Shisong-LI/Tsinghua-KB-Magnet-Open-Source/metadata/file-manifest.csv

path | source_path | size_bytes | sha256 | format | role
hardware/drawings/A5_Cover - 图纸.pdf | 图纸/A5_Cover - 图纸.pdf | 136703 | d9381b79babea124f1c9e8039828075bba117d09c8c25e4abf5d342fc5d3db3c | PDF | drawing-pdf
hardware/drawings/A5_Cover.SLDDRW | 图纸/A5_Cover.SLDDRW | 441877 | 97224264419adcaf0b62cd723ca5f9ee02789884d5e3d114f76e61529ae92d68 | SLDDRW | drawing
hardware/drawings/A5_Cover.SLDPRT | 图纸/A5_Cover.SLDPRT | 211247 | c3634bf68eb07473ba412b9cf486f4e0c87c6d2c47d599e6dcd05f07a0fd2de1 | SLDPRT | part
hardware/drawings/A5_Cover.STEP | 图纸/A5_Cover.STEP | 250598 | 1846d06651c39f89eef82ffe650faa5e057a3091f0c7ed0b60df97f60c061aa5 | STEP | exchange
hardware/drawings/A5_InnerL - 图纸.pdf | 图纸/A5_InnerL - 图纸.pdf | 63132 | 8e23bdd94e105e076f227bb8b3a257c28a4f538de69c8bba346e6d6d42adcec2 | PDF | drawing-pdf
hardware/drawings/A5_InnerL.SLDDRW | 图纸/A5_InnerL.SLDDRW | 182580 | 98d02a173ba5a83216cbe8c66720d75f1d4490e6fad9af991800a24dea2006e9 | SLDDRW | drawing
hardware/drawings/A5_InnerL.SLDPRT | 图纸/A5_InnerL.SLDPRT | 103981 | 073f107fbadd0505143599769134beae438c3ad43815fd00e06f6801c19ed73d | SLDPRT | part
hardware/drawings/A5_InnerL.STEP | 图纸/A5_InnerL.STEP | 31354 | a3d109f52731be0d8d959fe59bb94d309607ea42ef0b9fddd9e796b562a10067 | STEP | exchange
hardware/drawings/A5_InnerS - 图纸.pdf | 图纸/A5_InnerS - 图纸.pdf | 63033 | e7a253ab4c9a4071441f85f885e89a9850795416e2297c697473997f7caa80d7 | PDF | drawing-pdf
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
hardware/solidworks/内磁轭卡件V1.0.SLDPRT | 内磁轭卡件V1.0.SLDPRT | 250544 | edf80ae4a9b94ca8734a57c9467cfc0332b01028d7f0974bba070ce14b471a93 | SLDPRT | part
