Shisong-LI/Tsinghua-KB-Magnet-Open-Source/hardware/solidworks/01.THUKB-CY-01-00 M磁组.SLDASM

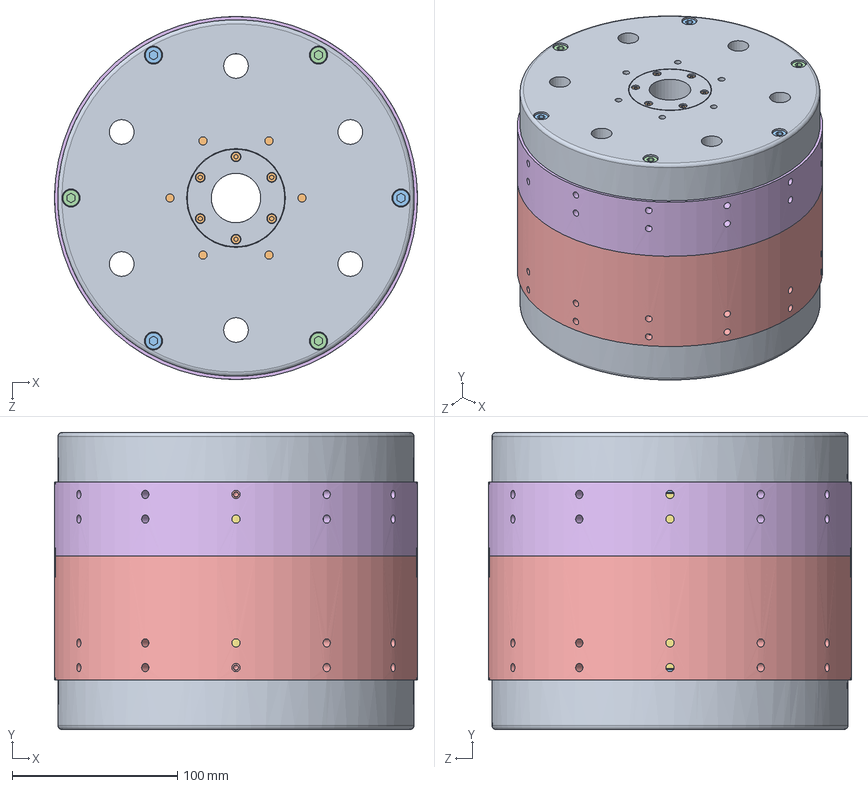
[picture p1: CAD file, 2026-11-11]
hardware/solidworks/01.THUKB-CY-01-00 M磁组.SLDASM
220.0 x 180.0 x 220.0 mm
A5_CoverV1.0 x 2
A5_SmCoV1.0 x 2
A5_InnerLV1.0
A5_InnerSV1.0
A5_OuterLV1.0
A5_OuterSV1.0
内磁轭卡件V1.0 x 2
下部磁体固定件V1.0
上部磁体固定件V1.0
内六角圆柱头螺钉M3×8 x 12
内六角圆柱头螺钉M6×30 x 9
内六角圆柱头螺钉M6×80 x 3
GB／T77-2000内六角平端紧定螺钉M6×10 x 6
