Shisong-LI/Tsinghua-KB-Magnet-Open-Source/hardware/drawings/下部磁体固定件.STEP

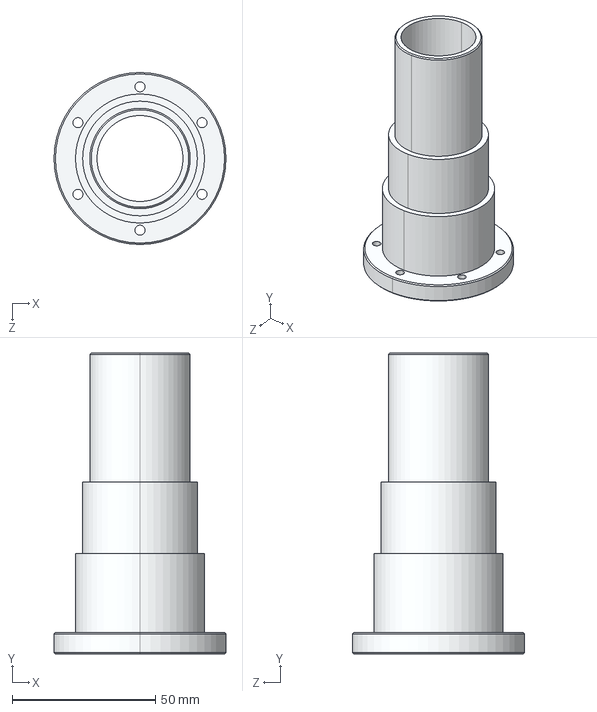
[picture p2: CAD file, 2026-11-11]
hardware/drawings/下部磁体固定件.STEP
60.0 x 105.0 x 60.0 mm
