Shisong-LI/Tsinghua-KB-Magnet-Open-Source/hardware/solidworks/上部磁体固定件V1.0.SLDPRT

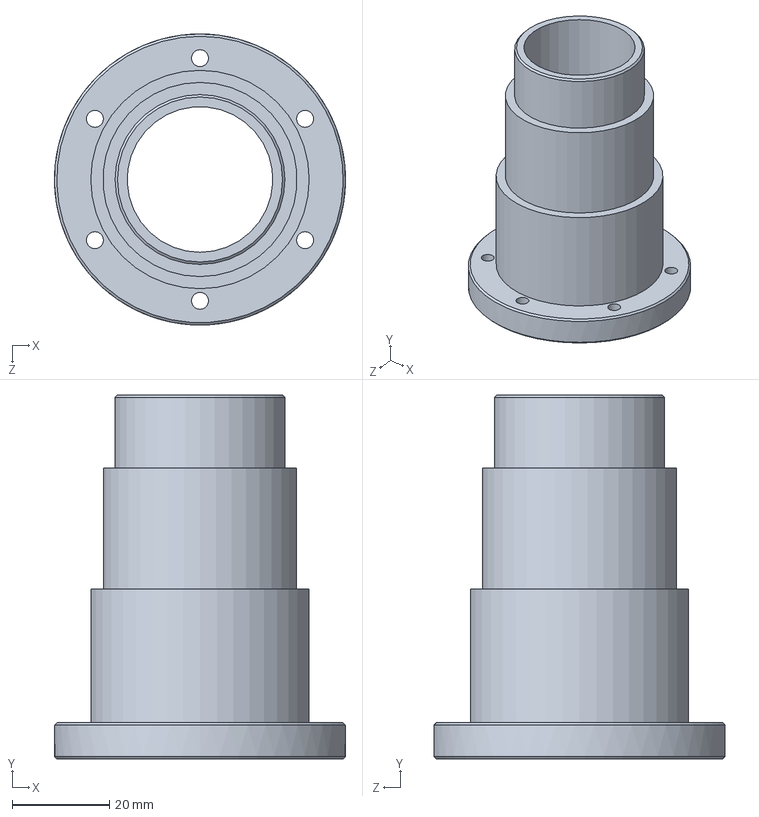
[picture p3: CAD file, 2026-11-11]
hardware/solidworks/上部磁体固定件V1.0.SLDPRT
60.0 x 75.0 x 60.0 mm
