Shisong-LI/Tsinghua-KB-Magnet-Open-Source/hardware/drawings/A5_InnerS.STEP

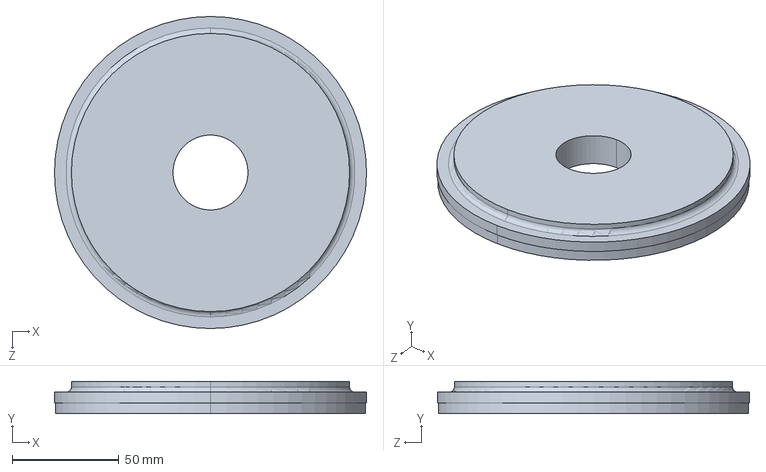
[picture p4: CAD file, 2026-11-11]
hardware/drawings/A5_InnerS.STEP
145.8 x 15.0 x 145.8 mm
