Shisong-LI/Tsinghua-KB-Magnet-Open-Source/hardware/solidworks/内六角圆柱头螺钉M6×30.SLDPRT

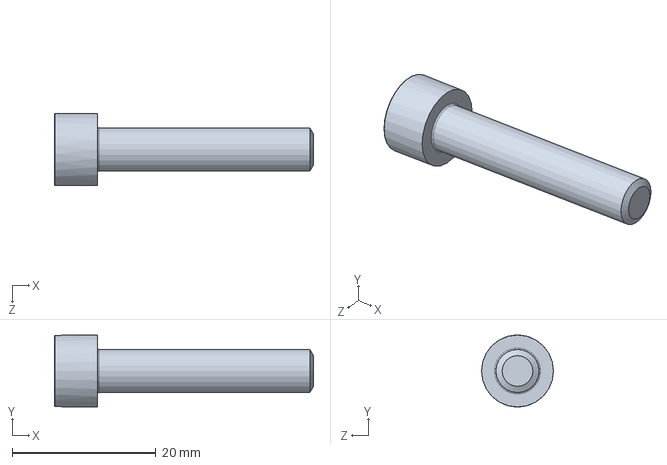
[picture p5: CAD file, 2026-11-11]
hardware/solidworks/内六角圆柱头螺钉M6×30.SLDPRT
36.0 x 10.0 x 10.0 mm
