Shisong-LI/Tsinghua-KB-Magnet-Open-Source/hardware/drawings/内磁轭卡件.STEP

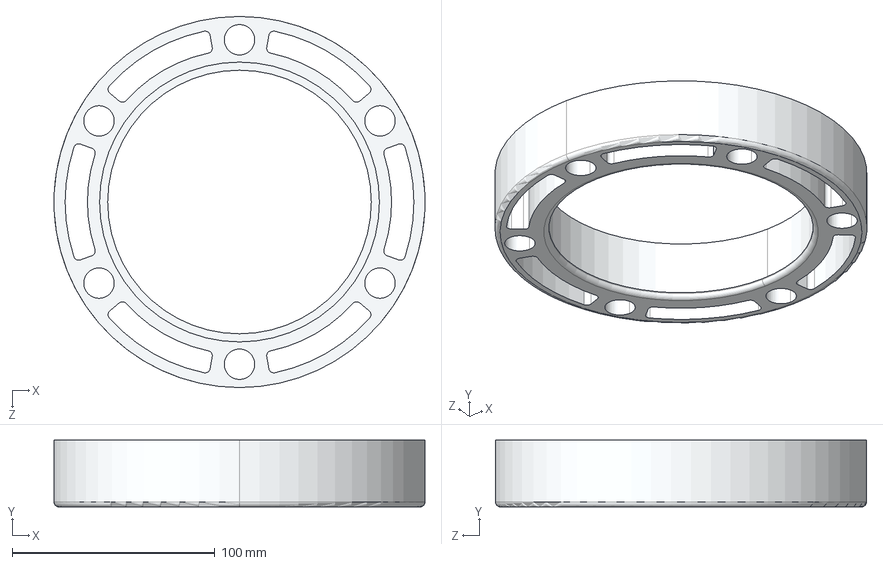
[picture p6: CAD file, 2026-11-11]
hardware/drawings/内磁轭卡件.STEP
183.0 x 33.0 x 183.0 mm
