Shisong-LI/Tsinghua-KB-Magnet-Open-Source/hardware/solidworks/内六角圆柱头螺钉M6×80.SLDPRT

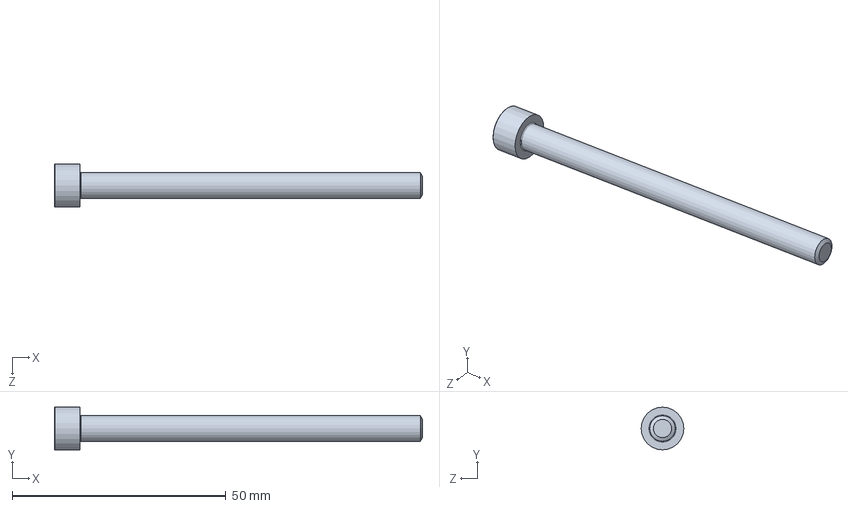
[picture p7: CAD file, 2026-11-11]
hardware/solidworks/内六角圆柱头螺钉M6×80.SLDPRT
86.0 x 10.0 x 10.0 mm
