Shisong-LI/Tsinghua-KB-Magnet-Open-Source/hardware/solidworks/A5_InnerSV1.0.SLDPRT

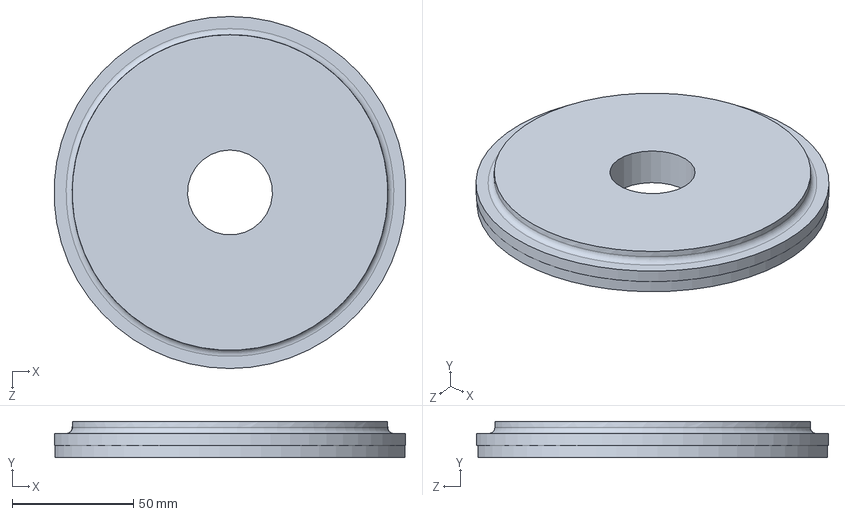
[picture p8: CAD file, 2026-11-11]
hardware/solidworks/A5_InnerSV1.0.SLDPRT
144.8 x 15.0 x 145.0 mm
