Shisong-LI/Tsinghua-KB-Magnet-Open-Source/hardware/drawings/A5_SmCo.SLDPRT

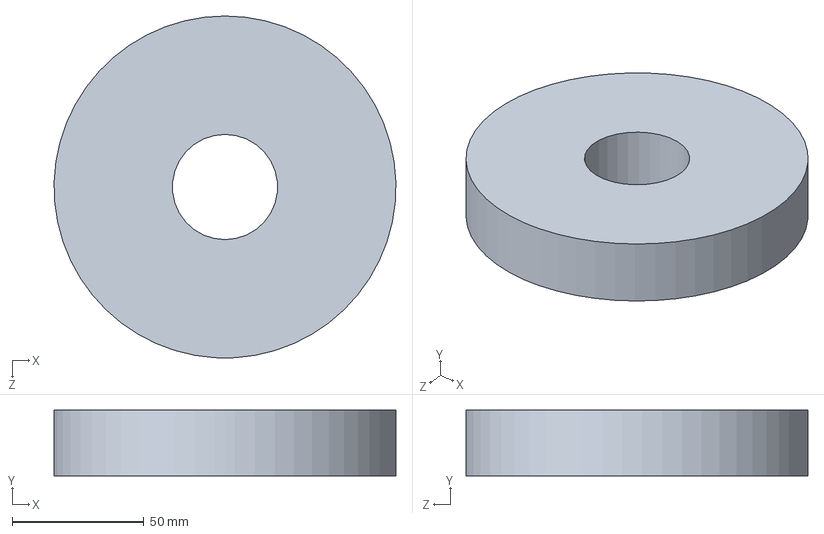
[picture p9: CAD file, 2026-11-11]
hardware/drawings/A5_SmCo.SLDPRT
129.9 x 25.0 x 130.0 mm
