Shisong-LI/Tsinghua-KB-Magnet-Open-Source/hardware/solidworks/A5_OuterSV1.0.SLDPRT

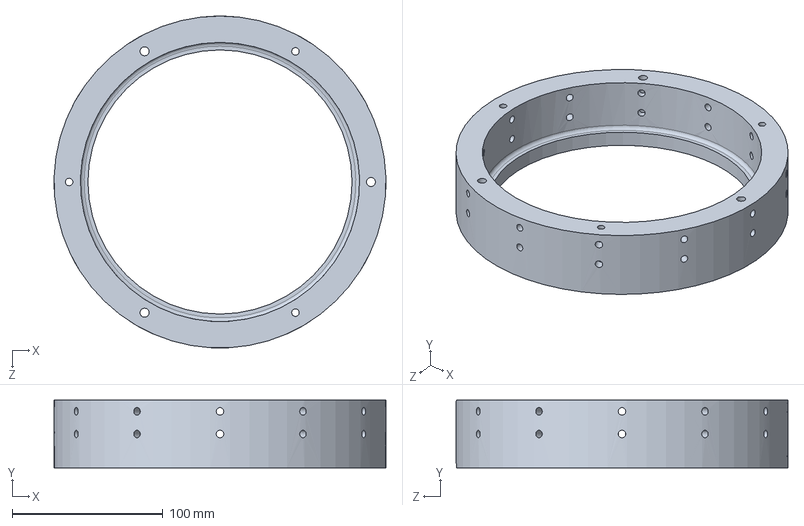
[picture p10: CAD file, 2026-11-11]
hardware/solidworks/A5_OuterSV1.0.SLDPRT
220.0 x 45.0 x 220.0 mm
