Shisong-LI/Tsinghua-KB-Magnet-Open-Source/hardware/drawings/A5_InnerL.STEP

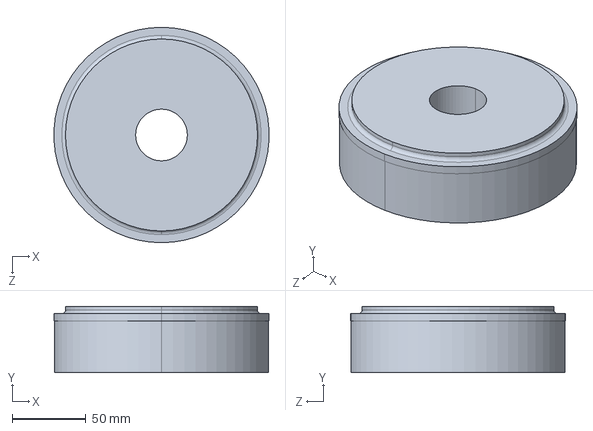
[picture p11: CAD file, 2026-11-11]
hardware/drawings/A5_InnerL.STEP
145.6 x 45.0 x 145.8 mm
