Shisong-LI/Tsinghua-KB-Magnet-Open-Source/hardware/drawings/A5_OuterS.STEP

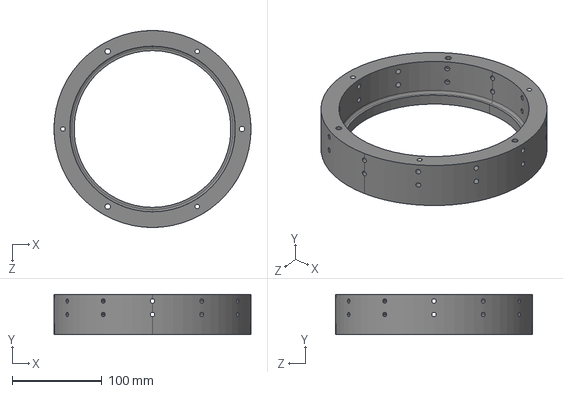
[picture p12: CAD file, 2026-11-11]
hardware/drawings/A5_OuterS.STEP
220.0 x 45.0 x 220.0 mm
