Shisong-LI/Tsinghua-KB-Magnet-Open-Source/hardware/drawings/A5_OuterLV1.0.STEP

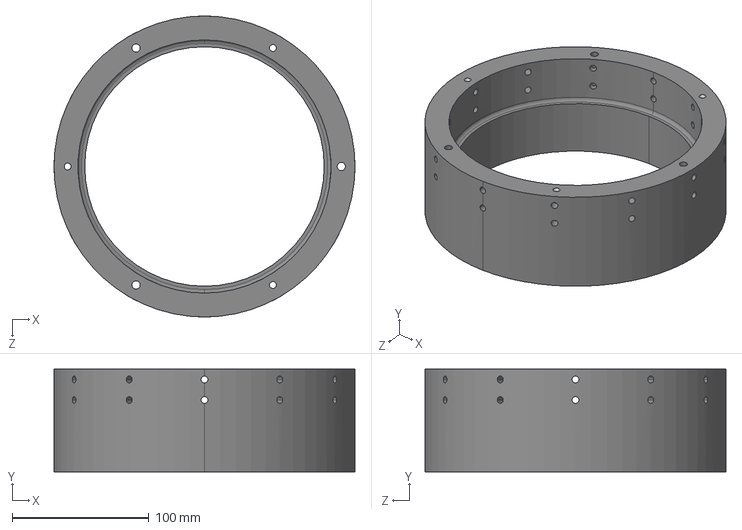
[picture p13: CAD file, 2026-11-11]
hardware/drawings/A5_OuterLV1.0.STEP
220.0 x 75.0 x 220.0 mm
