Shisong-LI/Tsinghua-KB-Magnet-Open-Source/hardware/solidworks/内磁轭卡件V1.0.SLDPRT

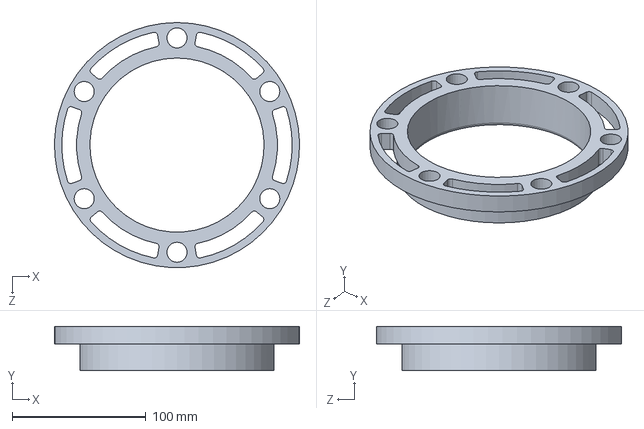
[picture p14: CAD file, 2026-11-11]
hardware/solidworks/内磁轭卡件V1.0.SLDPRT
182.9 x 33.0 x 182.8 mm
