Shisong-LI/Tsinghua-KB-Magnet-Open-Source/hardware/drawings/A5_Cover.STEP

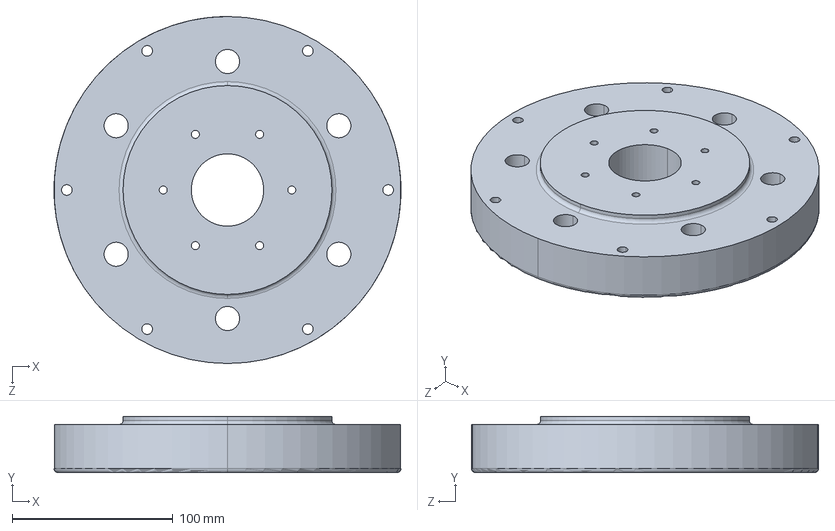
[picture p15: CAD file, 2026-11-11]
hardware/drawings/A5_Cover.STEP
216.0 x 35.0 x 216.0 mm
