Shisong-LI/Tsinghua-KB-Magnet-Open-Source/hardware/solidworks/A5_InnerLV1.0.SLDPRT

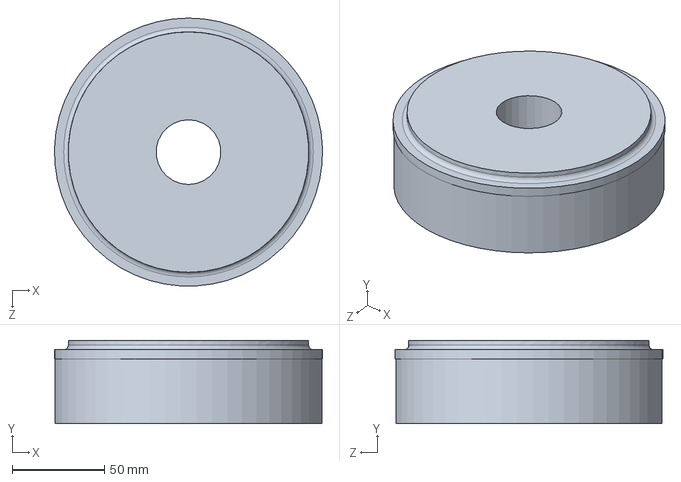
[picture p16: CAD file, 2026-11-11]
hardware/solidworks/A5_InnerLV1.0.SLDPRT
144.9 x 45.0 x 144.9 mm
