Shisong-LI/Tsinghua-KB-Magnet-Open-Source/hardware/solidworks/内六角圆柱头螺钉M3×8.SLDPRT

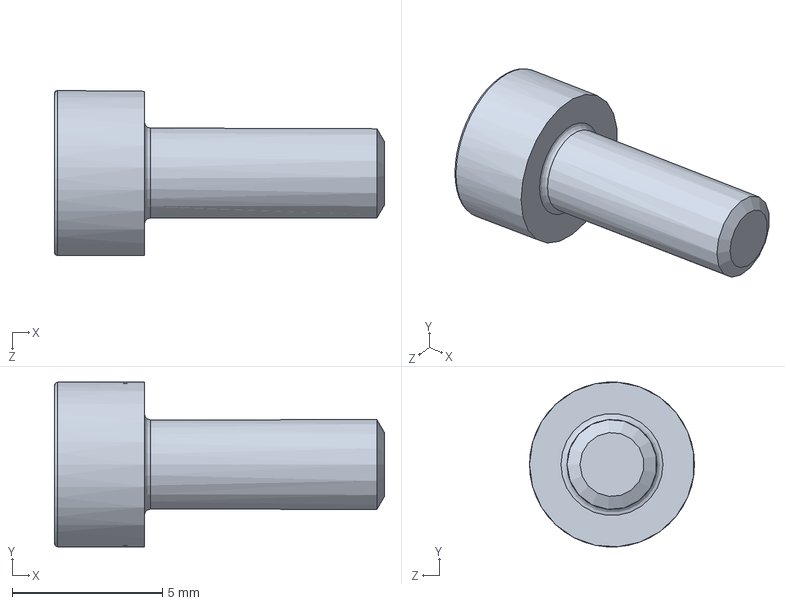
[picture p17: CAD file, 2026-11-11]
hardware/solidworks/内六角圆柱头螺钉M3×8.SLDPRT
11.0 x 5.49 x 5.50 mm
