Shisong-LI/Tsinghua-KB-Magnet-Open-Source/hardware/solidworks/GB／T77-2000内六角平端紧定螺钉M6×10.SLDPRT

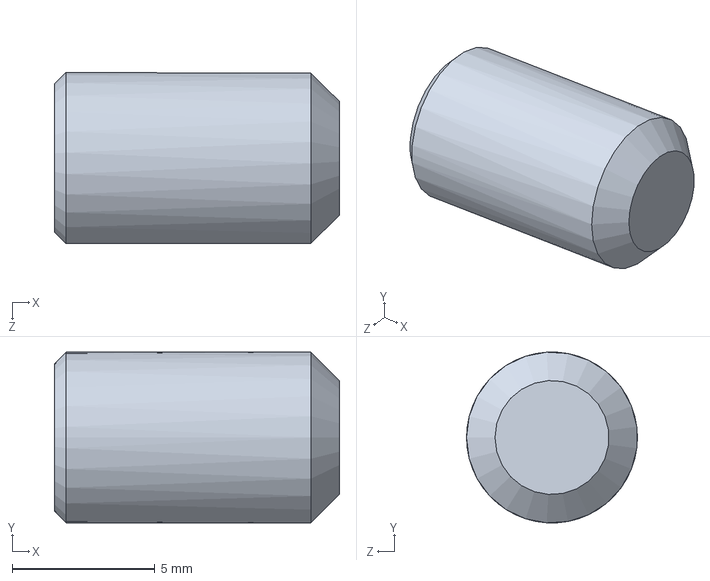
[picture p18: CAD file, 2026-11-11]
hardware/solidworks/GB／T77-2000内六角平端紧定螺钉M6×10.SLDPRT
10.0 x 5.99 x 6.00 mm
