Shisong-LI/Tsinghua-KB-Magnet-Open-Source/(list of files, cad)

Other CAD files:
hardware/drawings/上部磁体固定件.STEP
hardware/solidworks/下部磁体固定件V1.0.SLDPRT
hardware/solidworks/A5_SmCoV1.0.SLDPRT
hardware/solidworks/A5_CoverV1.0.SLDPRT
hardware/drawings/A5_Cover.SLDDRW
hardware/drawings/A5_Cover.SLDPRT
hardware/drawings/A5_InnerL.SLDDRW
hardware/drawings/A5_InnerL.SLDPRT
hardware/drawings/A5_InnerS.SLDDRW
hardware/drawings/A5_InnerS.SLDPRT
hardware/drawings/A5_OuterLV1.0.SLDDRW
hardware/drawings/A5_OuterLV1.0.SLDPRT
hardware/drawings/A5_OuterS.SLDDRW
hardware/drawings/A5_SmCo.SLDDRW
hardware/drawings/内磁轭卡件.SLDDRW
hardware/drawings/内磁轭卡件.SLDPRT
