Shisong-LI/Tsinghua-KB-Magnet-Open-Source/CHANGELOG.md

# Changelog

## Initial source package - 2026-11-11

- Packaged the supplied A5 magnet CAD and drawing snapshot with original names and bytes.
- Added English technical, CAD, manufacturing, validation, provenance, and publication documentation.
- Added article citation metadata, a compact paper fact sheet, and a scoped open-source licensing map.
- Added file inventories, SHA-256 verification, publication tooling, and GitHub Actions workflows.

This entry describes repository preparation. It is not a record of hardware fabrication or new experimental validation.
