Shisong-LI/Tsinghua-KB-Magnet-Open-Source/hardware/drawings/A5_Cover - 图纸.pdf

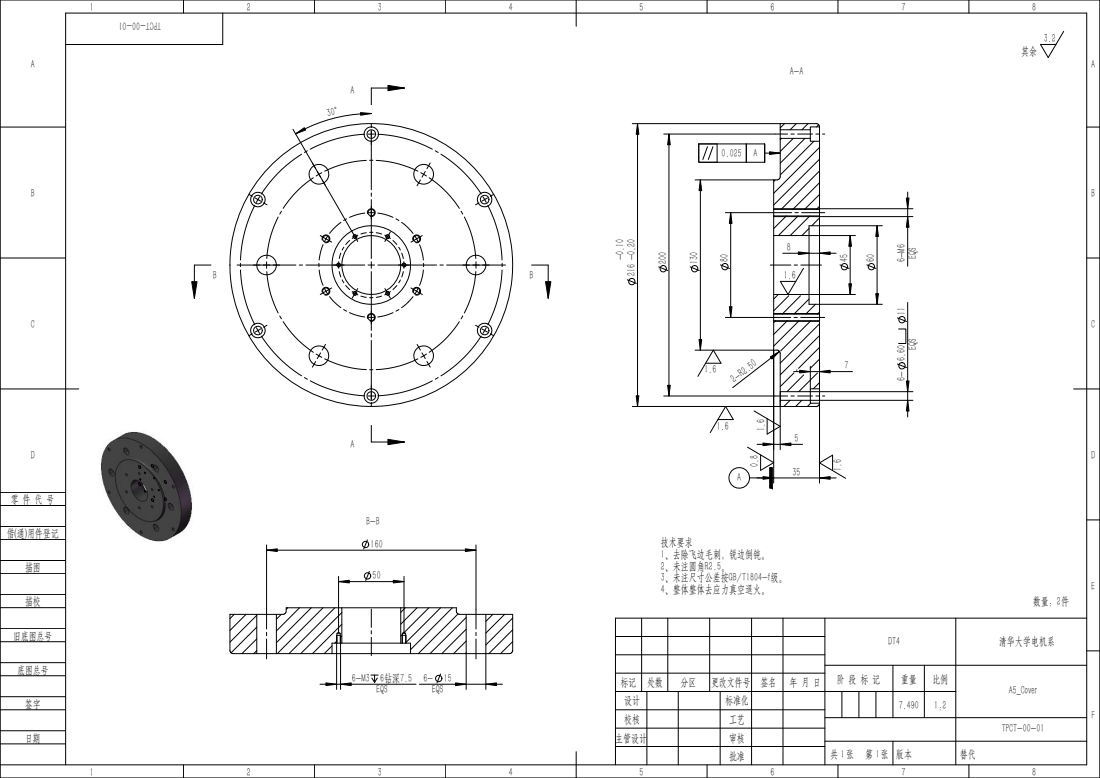
[picture p19: page 1]
旧底图总号; 比例 底图总号; 借(通)用件登记; EQS; 11 6- 6.60 6-M6 EQS; 技术要求 1、去除飞边毛刺，锐边倒钝。 2、未注圆角R2.5。 3、未注尺寸公差按GB/T1804-f级。 4、整体整体去应力真空退火。

DT4 | 清华大学电机系

阶 段 标 记 | 重量 | A5_Cover

分区 | 更改文件号 | 签名 | 年 月 日

设计 | | | 标准化 | | | | | 7.490 | 1:2
校核 | | | 工艺
主管设计 | | | 审核

TPCT-00-01
