Shisong-LI/Tsinghua-KB-Magnet-Open-Source/hardware/drawings/A5_InnerL - 图纸.pdf

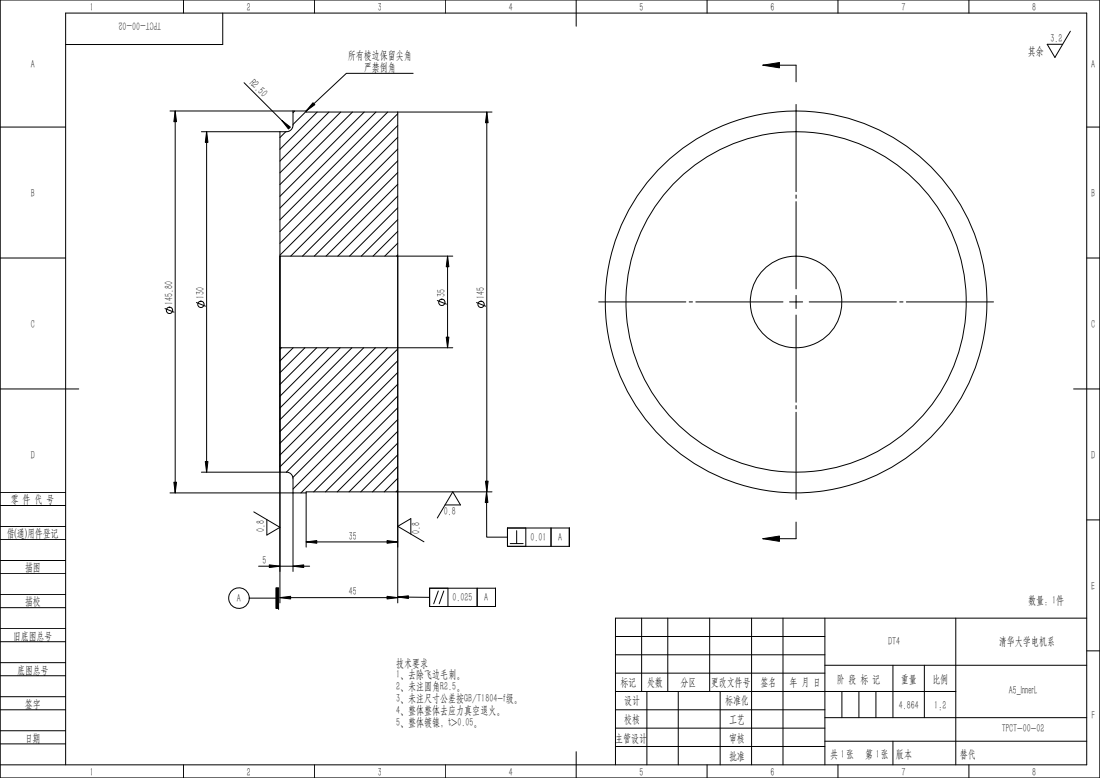
[picture p20: page 1]
底图总号; 旧底图总号; 借(通)用件登记; 3、未注尺寸公差按GB/T1804-f级。; 1、去除飞边毛刺。; 4、整体整体去应力真空退火。 5、整体镀镍，t>0.05。; 2、未注圆角R2.5。; 技术要求; 所有棱边保留尖角 严禁倒角

DT4 | 清华大学电机系

阶 段 标 记 | 重量 | 比例 | A5_InnerL

标记 | 处数 | 分区 | 更改文件号 | 签名 | 年 月 日
设计 | | | 标准化 | | | | | 4.864 | 1:2
校核 | | | 工艺
主管设计 | | | 审核

TPCT-00-02
