Shisong-LI/Tsinghua-KB-Magnet-Open-Source/hardware/drawings/A5_InnerS - 图纸.pdf

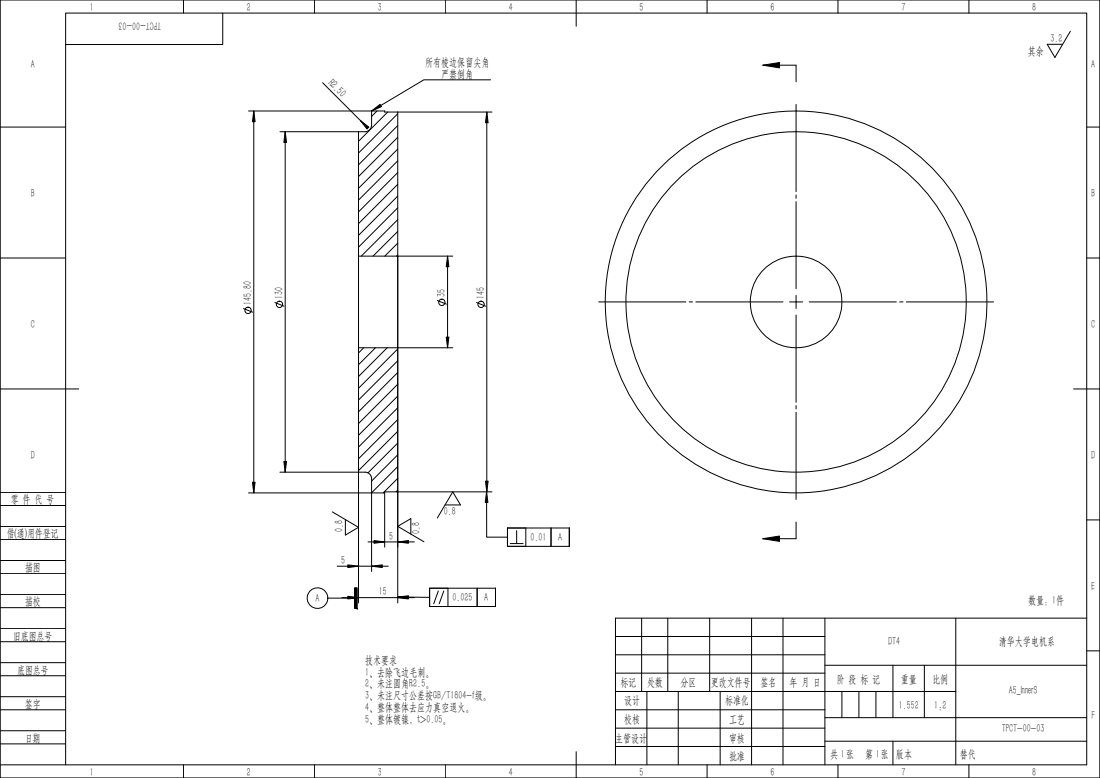
[picture p21: page 1]
底图总号; 旧底图总号; 借(通)用件登记; A5_InnerS; TPCT-00-03; 清华大学电机系; 所有棱边保留尖角 严禁倒角; 3、未注尺寸公差按GB/T1804-f级。; 1、去除飞边毛刺。; 4、整体整体去应力真空退火。 5、整体镀镍，t>0.05。; 2、未注圆角R2.5。; 技术要求

标记 | 处数 | 分区 | 更改文件号 | 签名 | 年 月 日
设计 | | | 标准化
校核 | | | 工艺
主管设计 | | | 审核
