Shisong-LI/Tsinghua-KB-Magnet-Open-Source/hardware/drawings/A5_OuterL-图纸.pdf

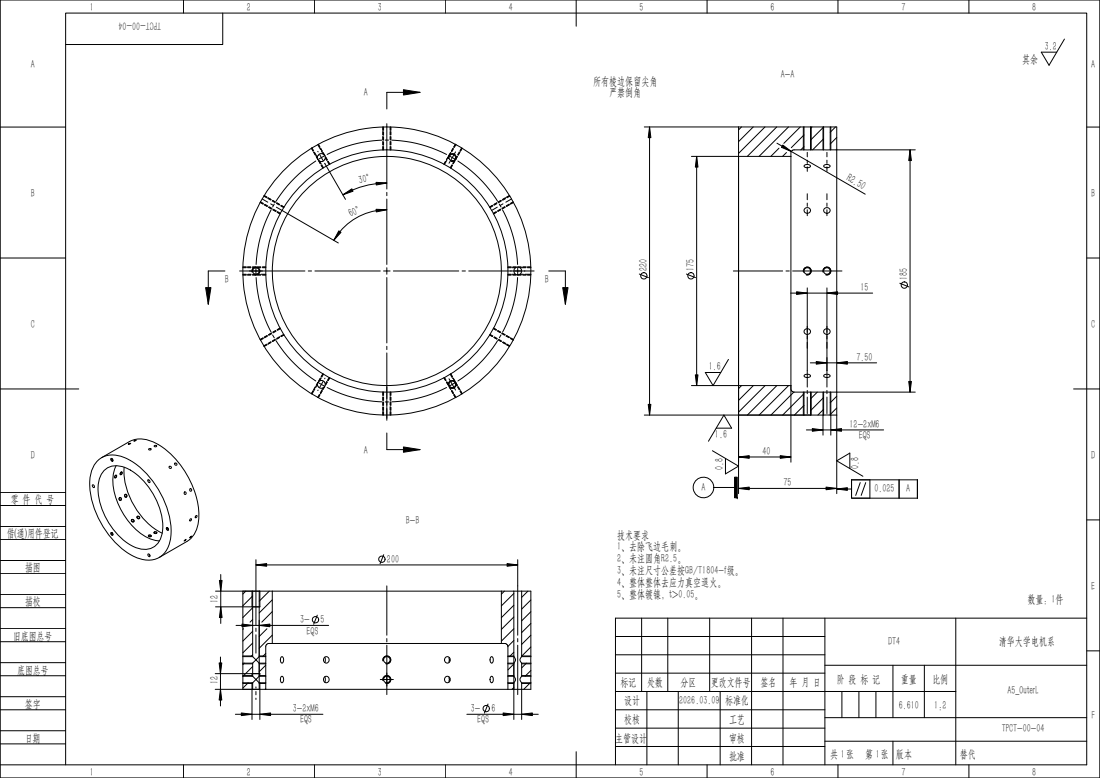
[picture p22: page 1]
底图总号; 旧底图总号; 借(通)用件登记; A5_OuterL; TPCT-00-04; 清华大学电机系; EQS; 严禁倒角; 所有棱边保留尖角; 2、未注圆角R2.5。; 1、去除飞边毛刺。; 3、未注尺寸公差按GB/T1804-f级。 4、整体整体去应力真空退火。; 5、整体镀镍，t>0.05。; 技术要求

标记 | 处数 | 分区 | 更改文件号 | 签名 | 年 月 日
设计 | | 2026.03.09 | 标准化
校核 | | | 工艺
主管设计 | | | 审核
