Shisong-LI/Tsinghua-KB-Magnet-Open-Source/hardware/drawings/A5_OuterS-图纸.pdf

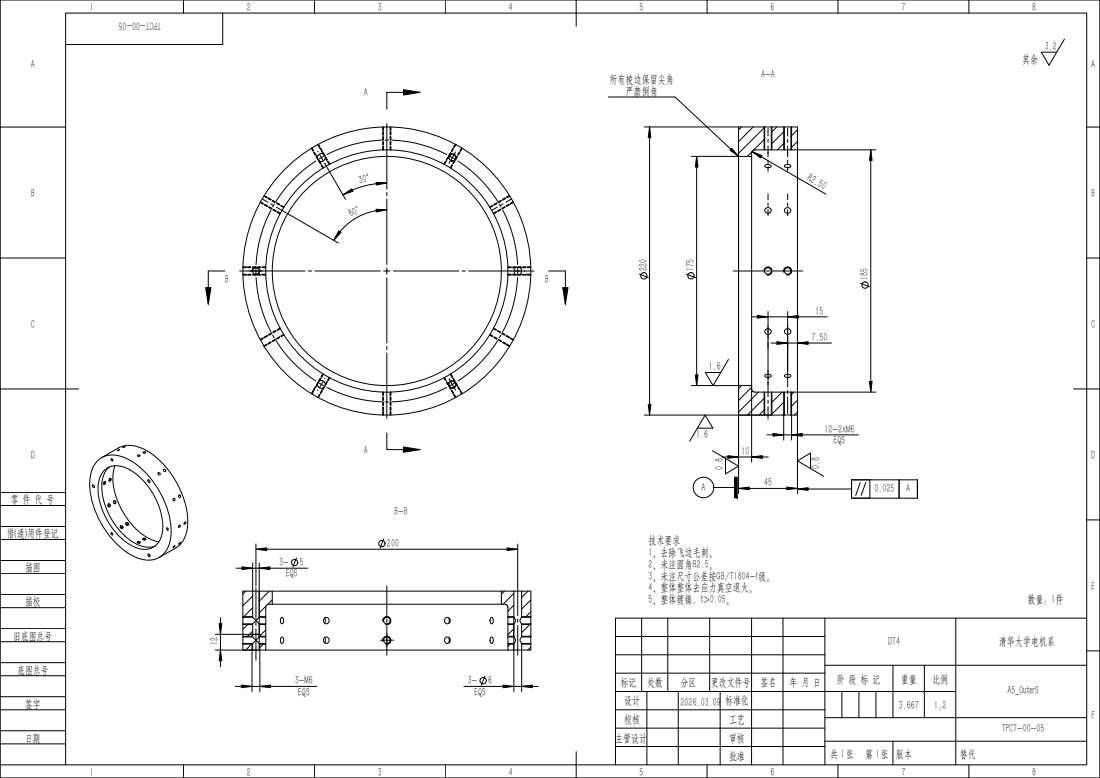
[picture p23: page 1]
底图总号; 旧底图总号; 借(通)用件登记; A5_OuterS; TPCT-00-05; 清华大学电机系; EQS; 3- 5 EQS; 4、整体整体去应力真空退火。; 3、未注尺寸公差按GB/T1804-f级。; 5、整体镀镍，t>0.05。; 1、去除飞边毛刺。 2、未注圆角R2.5。; 技术要求; A-A 所有棱边保留尖角; 严禁倒角

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
