Shisong-LI/Tsinghua-KB-Magnet-Open-Source/hardware/drawings/A5_SmCo - 图纸.pdf

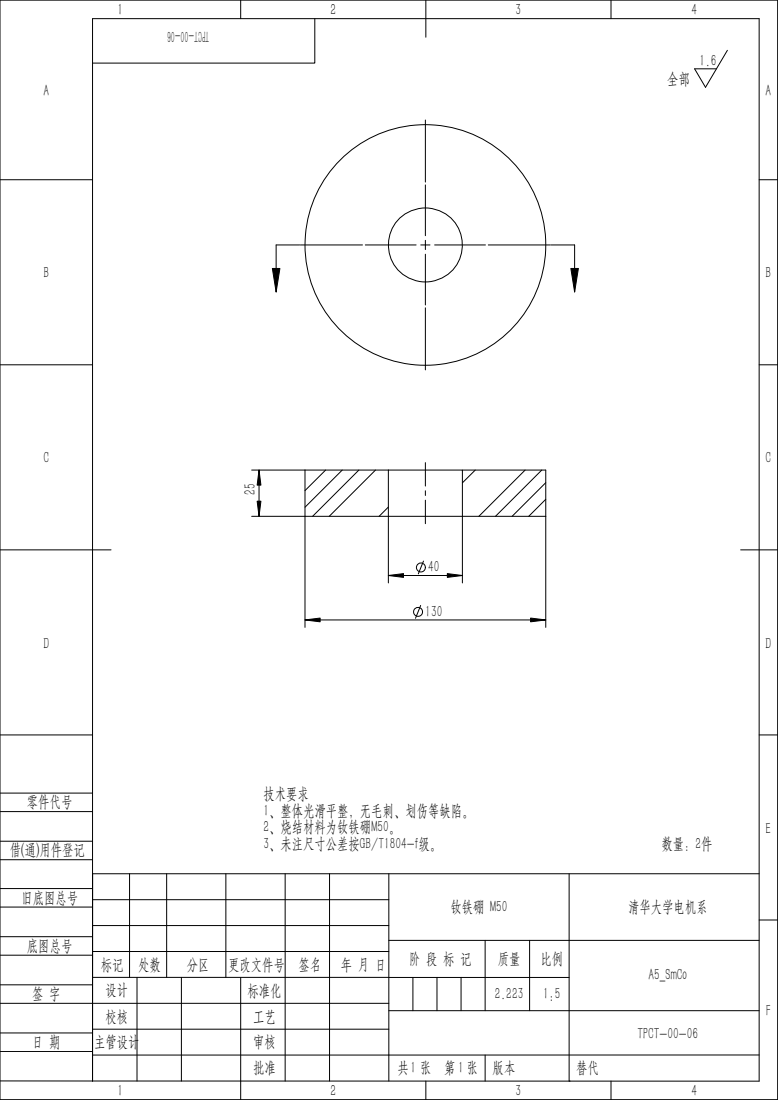
[picture p24: page 1]
底图总号; 旧底图总号; 借(通)用件登记; 零件代号

技术要求
1、整体光滑平整，无毛刺、划伤等缺陷。
2、烧结材料为钕铁硼M50。
3、未注尺寸公差按GB/T1804-f级。

钕铁硼 M50 | 清华大学电机系

阶 段 标 记 | 质量 | 比例 | A5_SmCo

标记 | 处数 | 分区 | 更改文件号 | 签名 | 年 月 日
设计 | | | 标准化 | | | | | 2.223 | 1:5
校核 | | | 工艺
主管设计 | | | 审核

TPCT-00-06
