Shisong-LI/Tsinghua-KB-Magnet-Open-Source/hardware/drawings/上部磁体固定件.pdf

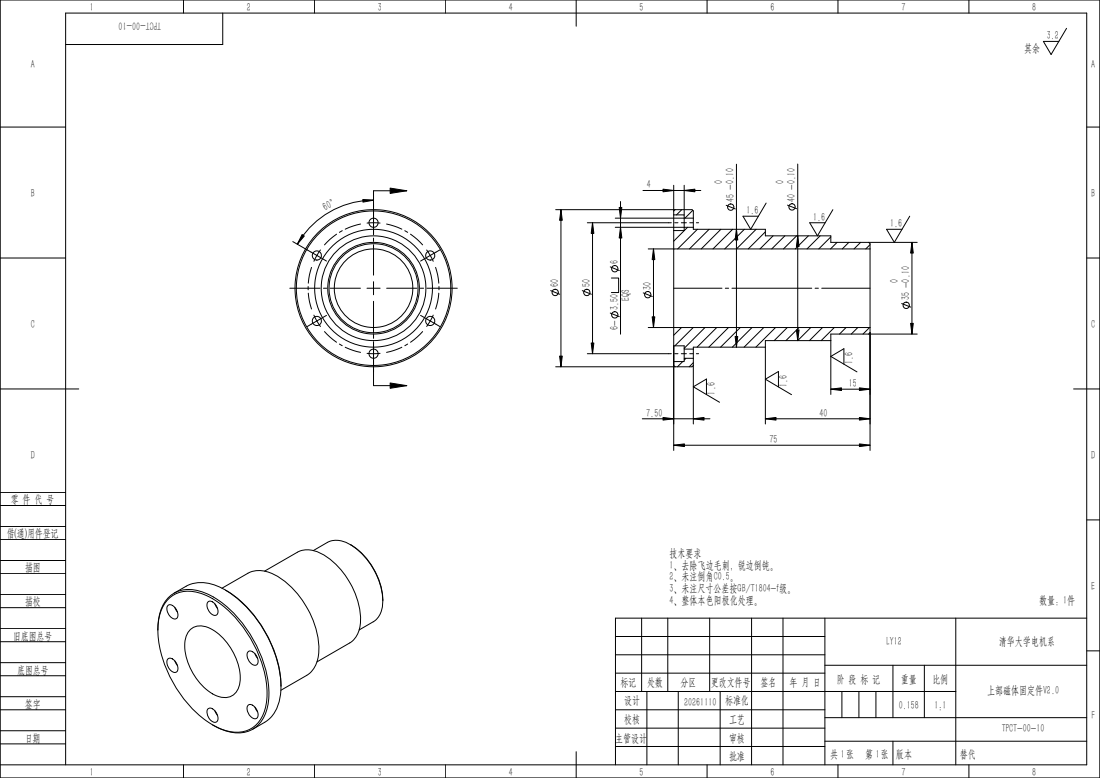
[picture p25: page 1]
底图总号; 旧底图总号; 借(通)用件登记; 技术要求; 1、去除飞边毛刺，锐边倒钝。 2、未注倒角C0.5。 3、未注尺寸公差按GB/T1804-f级。 4、整体本色阳极化处理。; EQS

LY12 | 清华大学电机系

阶 段 标 记 | 重量 | 比例 | 上部磁体固定件V2.0

标记 | 处数 | 分区 | 更改文件号 | 签名 | 年 月 日
设计 | | 20261110 | 标准化 | | | | | 0.158 | 1:1
校核 | | | 工艺
主管设计 | | | 审核

TPCT-00-10
