Shisong-LI/Tsinghua-KB-Magnet-Open-Source/hardware/drawings/下部磁体固定件.pdf

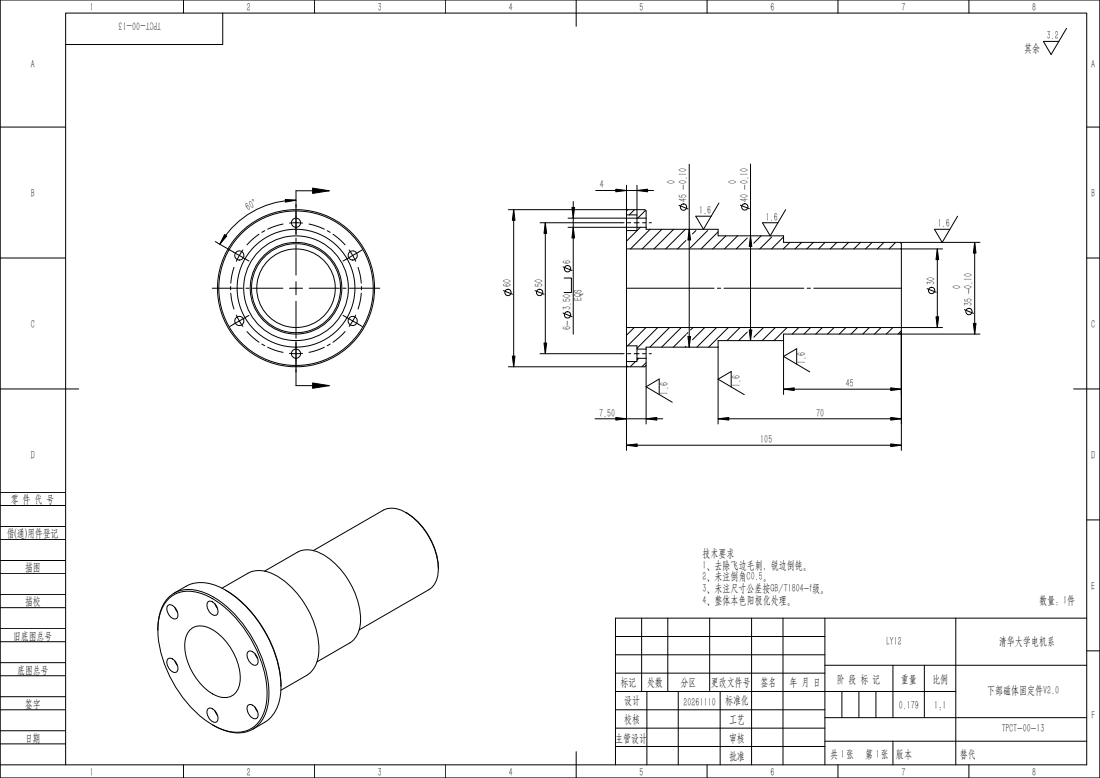
[picture p26: page 1]
底图总号; 旧底图总号; 借(通)用件登记; 下部磁体固定件V2.0; TPCT-00-13; 清华大学电机系; 3、未注尺寸公差按GB/T1804-f级。; 技术要求 1、去除飞边毛刺，锐边倒钝。 2、未注倒角C0.5。; 4、整体本色阳极化处理。; EQS

标记 | 处数 | 分区 | 更改文件号 | 签名 | 年 月 日
设计 | | 20261110 | 标准化
校核 | | | 工艺
主管设计 | | | 审核
