Shisong-LI/Tsinghua-KB-Magnet-Open-Source/hardware/drawings/内磁轭卡件 - 图纸1.pdf

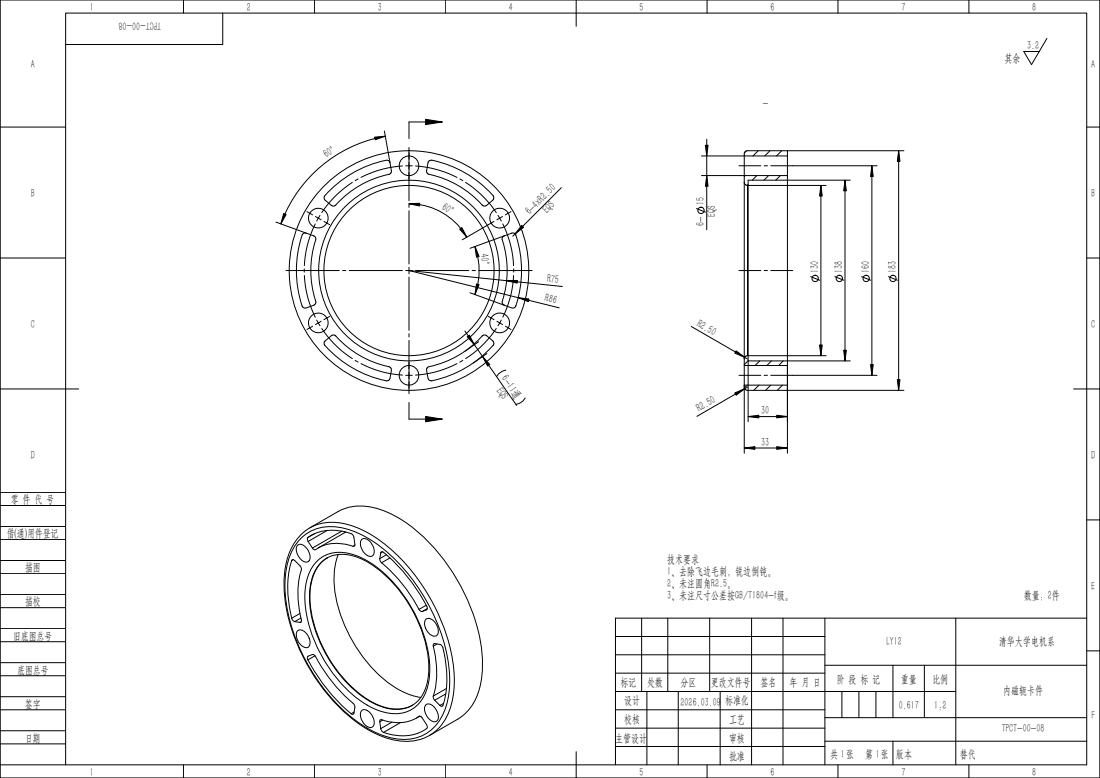
[picture p27: page 1]
底图总号; 旧底图总号; 借(通)用件登记; 内磁轭卡件; TPCT-00-08; 清华大学电机系; 6-4xR2.50 EQS; 3、未注尺寸公差按GB/T1804-f级。; 技术要求 1、去除飞边毛刺，锐边倒钝。 2、未注圆角R2.5。; EQS

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
